Outdatedcandy92/FM-Transmitter/README.md

# USB FM Transmitter

This project is a compact USB controlled FM transmitter module designed to stream and transmit audio directly from your computer to a FM band. This is a plug and play module and will work without installing any drivers or running any custom commands. Just simply plug it into your PC and start transmitting audio. This project uses the PCM2704 to receive audio from the host device and sends it off to the KT0803L chip to transmit over FM band. There are test pads on the board for the PCM2704 chips HID controls such as Mute, Volume Up/Down and Suspend. There is also a connector on board for communicating over I2C with the KT0803L. You can use I2C to change KT0803L's Transmitting Frequency, calibration parameters, operation statues, mode and power controller. 

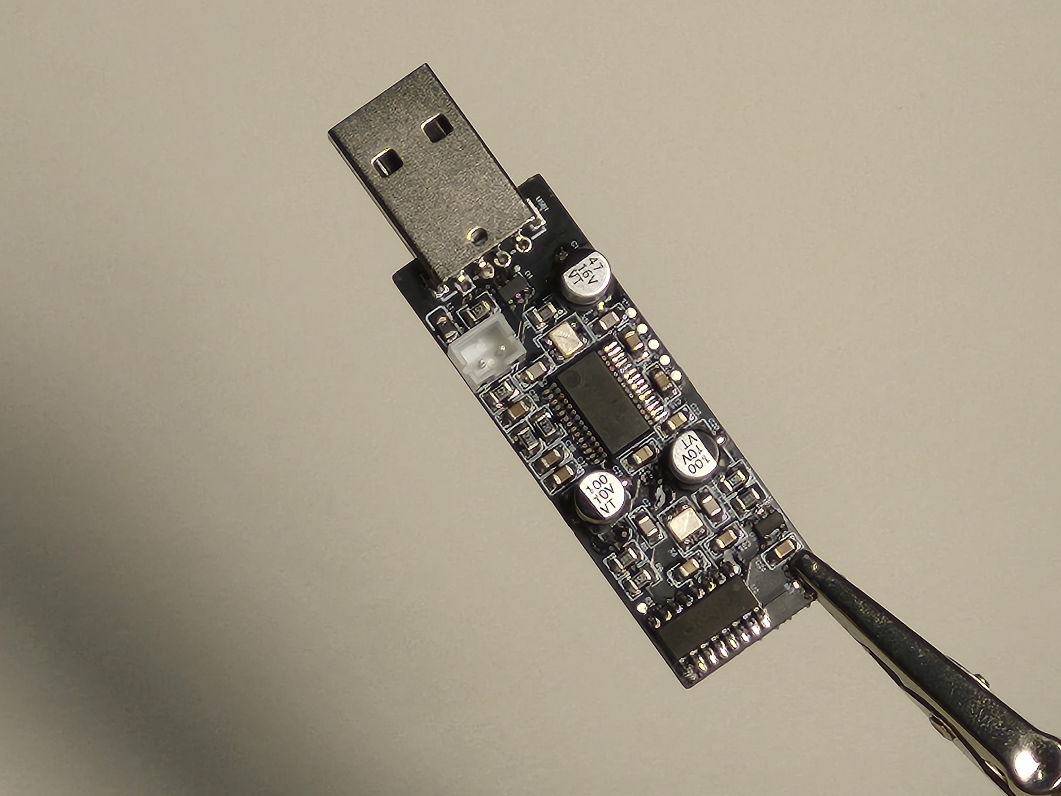
[picture p1: attachments/20250627_203439.jpg]

## V1 Demo

https://github.com/user-attachments/assets/b6735c28-1eea-4149-aa80-006a72d71160

## Code
Even though this board is plug and play, you can still program it over I2C to change settings on the KT0803 chip.
The code in `src/code.py` lets you change the output frequency of the chip. To run that code you must first connected the sda and scl pins on the board to any microcontroller that supports micro/circuitpython and that they both are connected to the same device (share the same ground). there is no need to add external pull up resistors as the KT0803 chip already has them inbuilt.

## V1

### Schematic

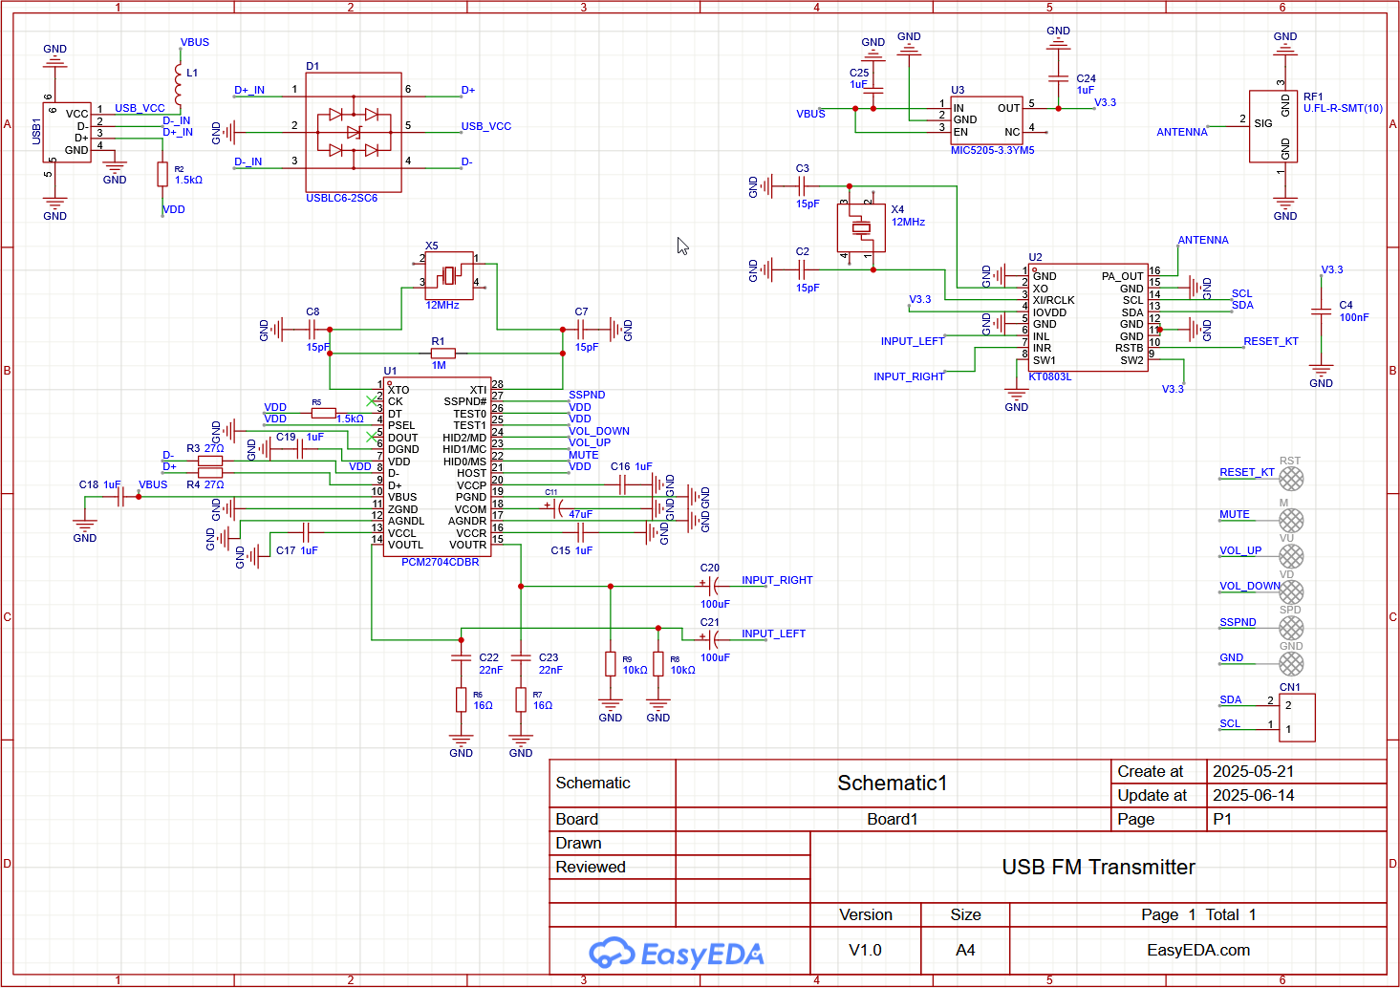
[picture p2: attachments/zen_QrhJHNvp3r.png]

### PCB

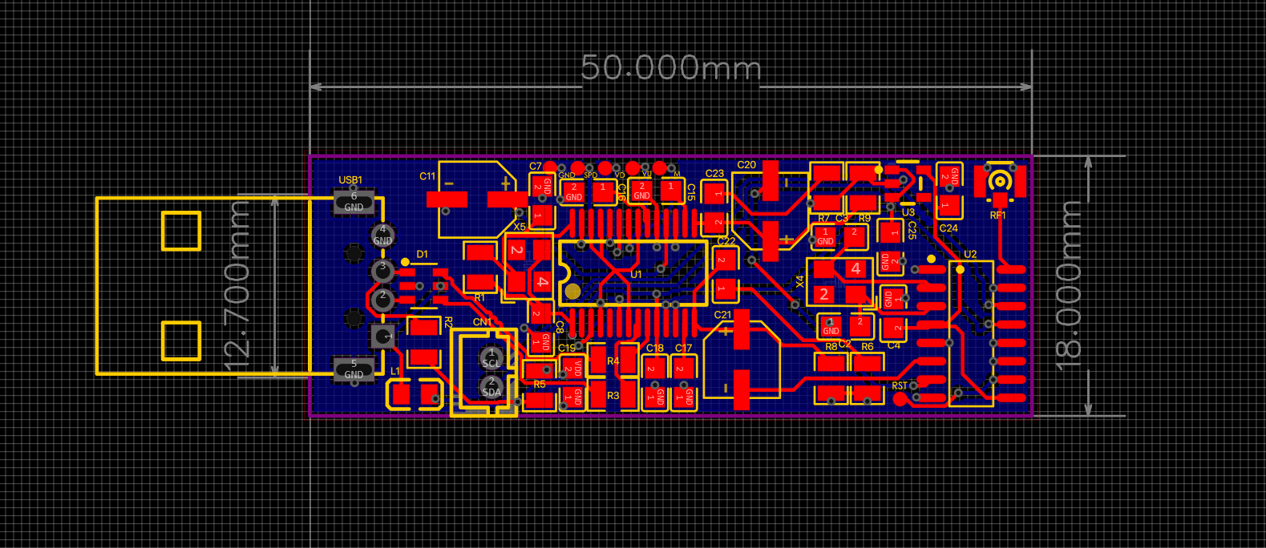
[picture p3: attachments/zen_INPOopee6o.png]


### 3D 

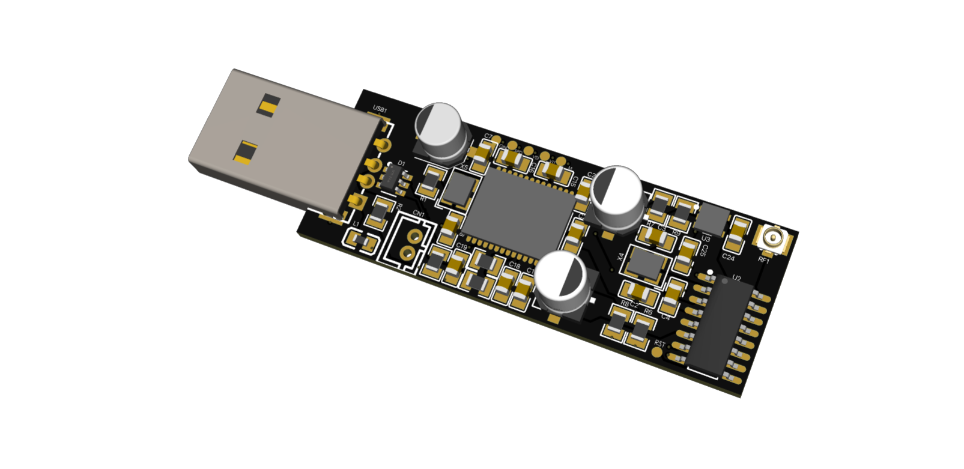
[picture p4: attachments/zen_fVa9baPrbY.png]


# V2!!

Version 2 of this board includes an onboard USB hub and MCU that way you no longer need to use an external devboard to change frequencies. It also has two onboard buttons and led to change and display the frequency!!

	V2 has been assembled and tested. Although I have not yet had the chance to write firmware for the Silicon Labs Chip. If you want to make your own I would recommend using a different MCU (like an STM32) as its easier to bringup.

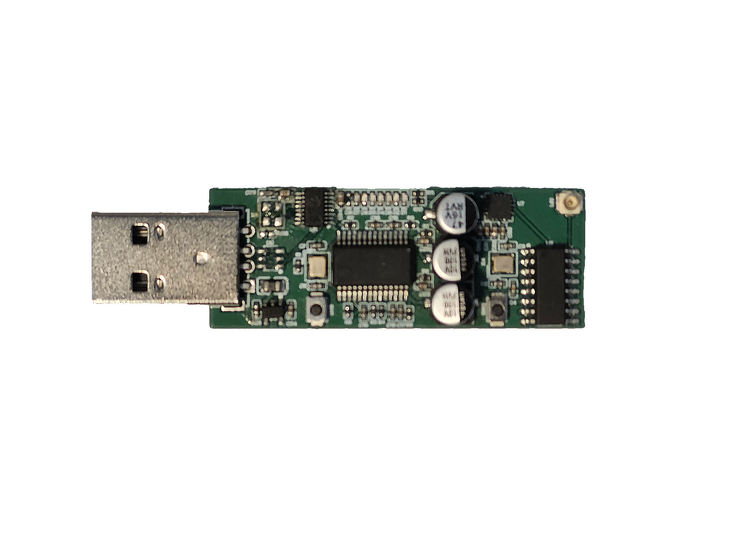
[picture p5: attachments/20260102_131213.png]


### Schematic

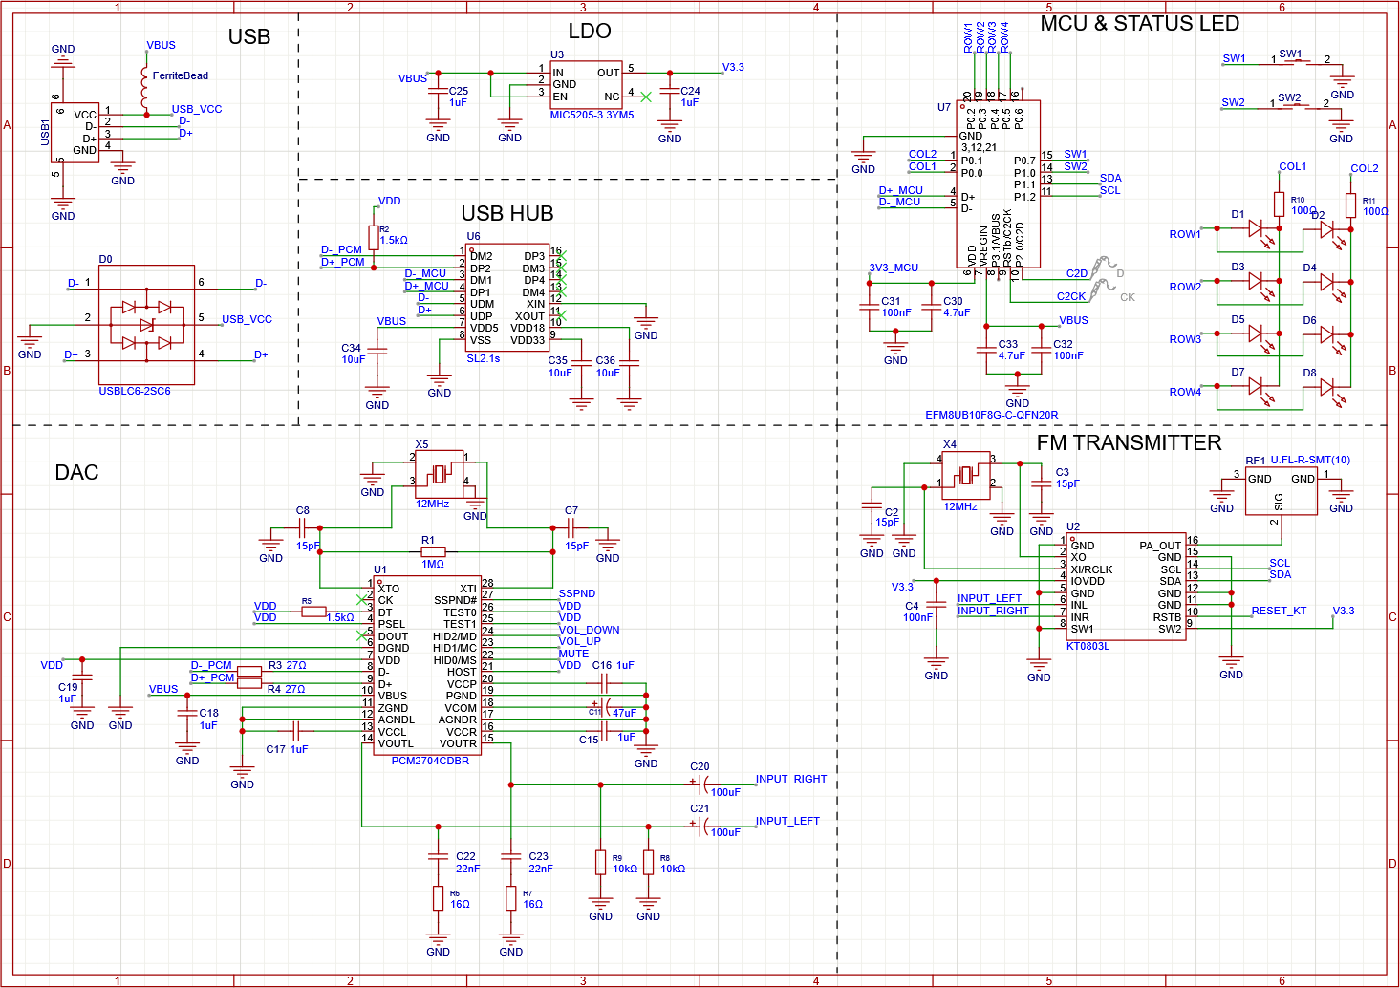
[picture p6: attachments/zen_RgUCC1Kti3.png]


### PCB

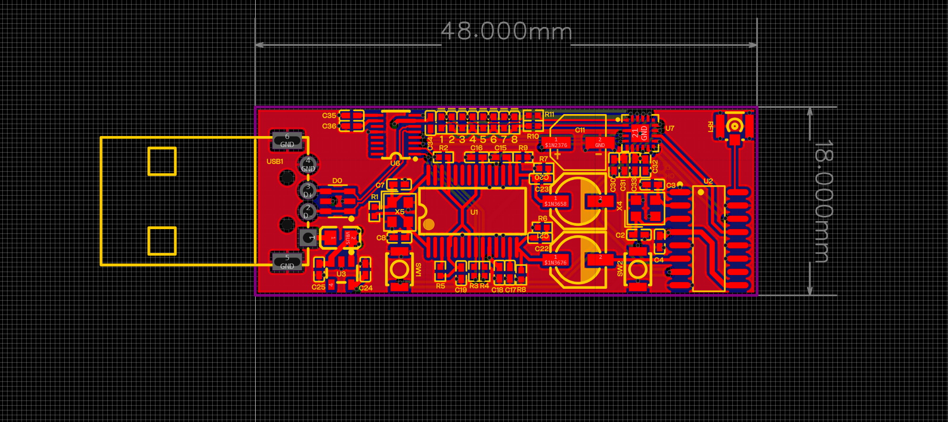
[picture p7: attachments/zen_ev1RDEKy1a.png]


### 3D

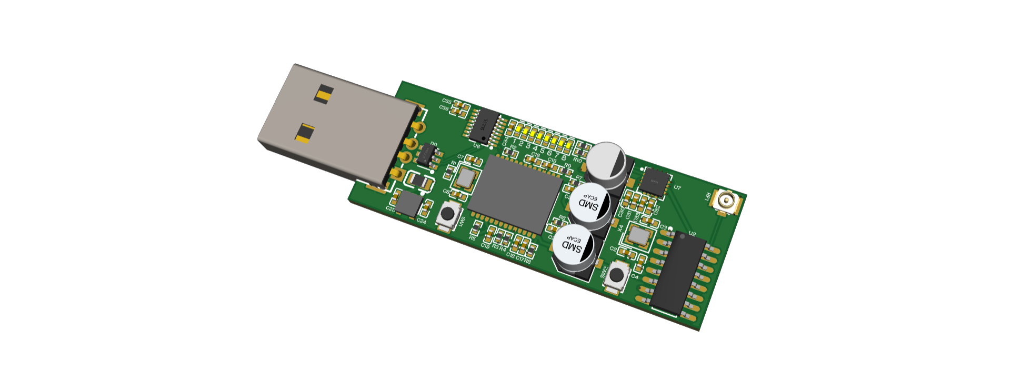
[picture p8: attachments/zen_EJJ06B7tOy.png]


## BOM 

	For V2

| Component | Quantity | Price |
| --- | --- | --- |
| PCB+Stencil | MOQ | $17.88 |
| [Componenets](./src/V2/production/BOM.csv)(lcsc) | - | $34.05 ($21+$12 Shipping) |
| [EFM8UB10F8G-C-QFN20R Digikey](https://www.digikey.ca/en/products/detail/silicon-labs/EFM8UB10F8G-C-QFN20/5592436) Out of stock at lcsc | 2 | $13.29 ($8 Shipping) |
| [Oscilloscope Probe](https://www.aliexpress.com/item/1005003950007418.html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) | 1 | $7 |
| [Test Hooks](https://www.aliexpress.com/item/1005009494803550.html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) | 1 set | $5 |
| **Total** | | $76 |
