Outdatedcandy92/FM-Transmitter/attachments/zen_FpW6MBPsa5.png

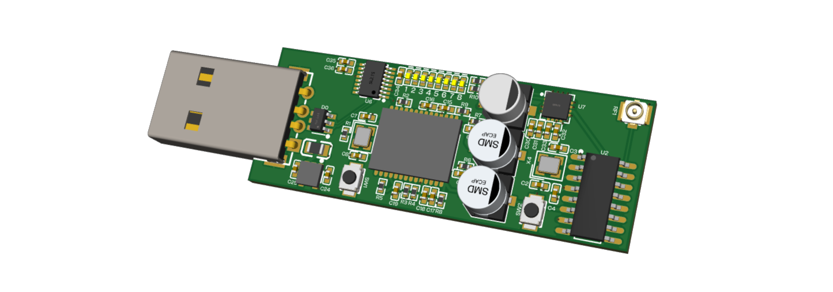
attachments/zen_FpW6MBPsa5.png
