Outdatedcandy92/FM-Transmitter/src/V2/production/BOM.csv

No. | Quantity | Footprint | Value | Device | LCSC Stock | LCSC Price | JLCPCB Stock | JLCPCB Price
1 | 1 | SSOP-28_L10.2-W5.3-P0.65-LS7.8-BL |  | PCM2704CDBR |  |  | 1255 | 0.6585
2 | 1 | SOP-16_L9.9-W3.9-P1.27-LS6.0-BL |  | KT0803L |  |  | 0 | 0.0053
3 | 1 | CAP-SMD_BD5.0-L5.3-W5.3-FD | 47uF | RVT1C470M0505 |  |  | 3229 | 0.0039
4 | 1 | L0805 |  | MPZ1608S101ATAH0 |  |  | 159262 | 0.0014
5 | 1 | SOT-23-6_L2.9-W1.6-P0.95-LS2.8-BL |  | USBLC6-2SC6 |  |  | 0 | 0.0112
6 | 1 | SOT-23-5_L2.9-W1.6-P0.95-LS2.8-BR |  | MIC5205-3.3YM5 |  |  | 0 | 0.0126
7 | 1 | CAP-SMD_BD5.0-L5.3-W5.3-FD | 100uF | RVT1E101M0607 |  |  | 6797 | 0.0047
8 | 1 | ANT-SMD_UFL-R-SMT01 |  | U.FL-R-SMT(10) |  |  | 5296 | 0.0435
9 | 1 | USB-A-TH_U-G-04WD-W-01 |  | U-G-O4DD-W-1 |  |  | 422 | 0.0123
10 | 1 | C0402 | 15pF | 0402CG150J500NT |  |  | 807110 | 0.0002
11 | 1 | C0402 | 100nF | CAP_0402,CL05B104KO5NNNC |  |  | 17436046 | 0.0002
12 | 1 | C0402 | 15pF | 0402CG150J500NT
13 | 1 | C0402 | 1uF | CL10A105KO8NNNC |  |  | 1557259 | 0.0005
14 | 1 | C0402 | 22nF | 0402B223K500NT |  |  | 436944 | 0.0003
15 | 1 | R0402 |  | 1M |  |  | 2647474 | 0.0001
16 | 1 | R0402 | 1.5kΩ | 0402WGF1501TCE |  |  | 951315 | 0.0001
17 | 1 | R0402 | 27Ω | 0402WGF270JTCE |  |  | 60063 | 0.0001
18 | 1 | R0402 | 16Ω | 0603WAF160JT5E |  |  | 470 | 0.0002
19 | 1 | R0402 | 10kΩ | 0402WGJ0103TCE |  |  | 3147179 | 0.0001
20 | 1 | SSOP-16_L4.6-W2.6-P0.53-LS4.0-BL |  | SL2.1s |  |  | 7909 | 0.0315
21 | 1 | CRYSTAL-SMD_4P-L2.5-W2.0-BL-A | 12MHz | SX2B12.000F1010F30 |  |  | 14547 | 0.0133
22 | 1 | C0402 | 4.7u | CAP_0402
23 | 1 | QFN-20_L3.0-W3.0-P0.50-TL-EP1.7_SILICON_C8051F85X |  | EFM8UB10F8G-C-QFN20R |  |  | 0 | 0.1835
24 | 1 | R0402 | 100 | 0402WGJ0103TCE
25 | 1 | LED0402-RD_GREEN |  | XL-1005UGC_C965793 |  |  | 257072 | 0.0011
26 | 1 | KEY-SMD_B3U-1000PM |  | B3U-1000P_C231329 |  |  | 28147 | 0.0217
