Outdatedcandy92/FM-Transmitter/src/V2/schemin.pdf

USB | LDO

# USB HUB

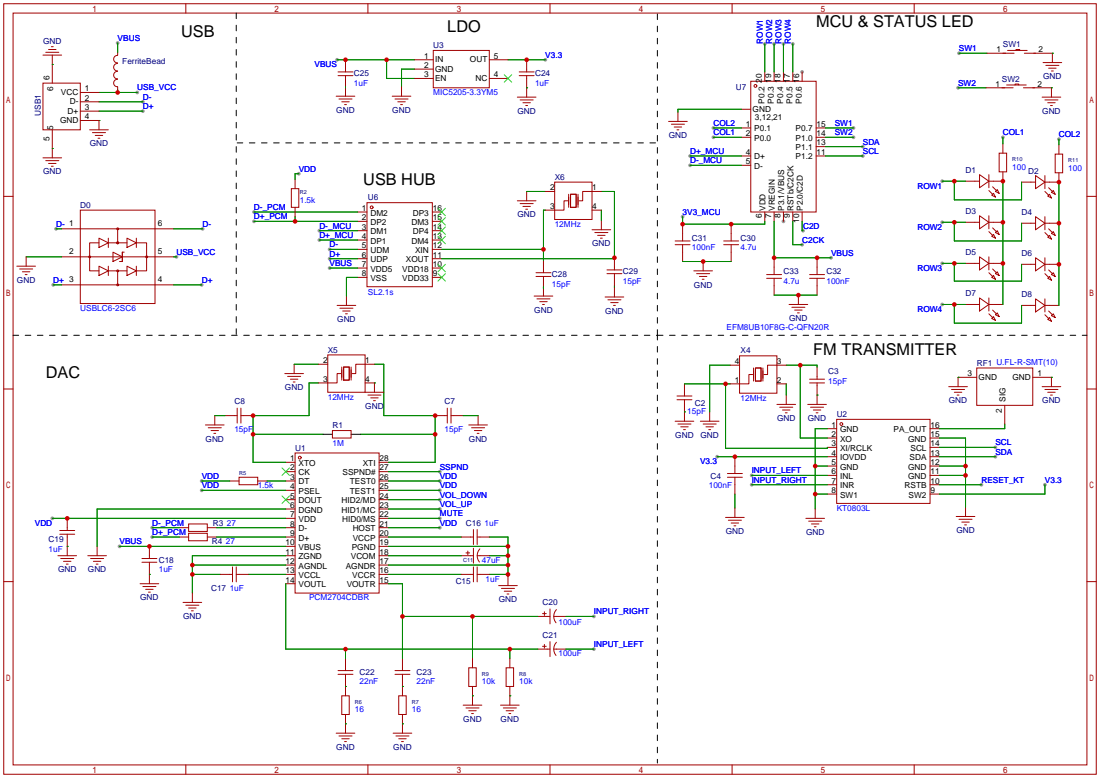
[picture p10: page 1]

RSTB 10 GND 11 GND 12 SDA 13 SCL 14 GND 15 PA_OUT 16
