Outdatedcandy92/FM-Transmitter/(list of files, drawings)

Other design files:
src/V1/EasyEDA.epro
src/V2/EasyEDA.epro
