Outdatedcandy92/FM-Transmitter/(commit log)

2025-06-30 fixed pcb
    [EasyEDA.epro]
2025-07-24 version 2
    [BOM.csv, BOM_Board1_1_PCB1_1_2025-07-24.csv, EasyEDA.epro]
2025-08-01 eda file
    [BOM.csv]
